ruxxzif89/rb87-eit-lab-guide/diy-stl/sas-cell-assembly-reference.stl

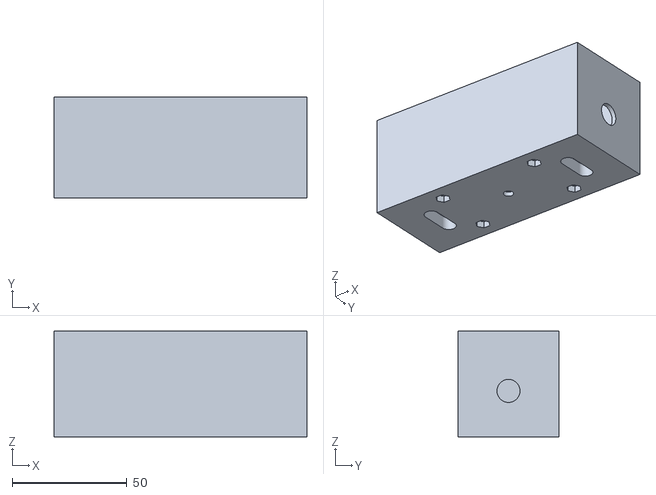
[picture p1: CAD file, 2026-10-17]
diy-stl/sas-cell-assembly-reference.stl
110.0 x 44.0 x 46.0
