ruxxzif89/rb87-eit-lab-guide/diy-stl/pbs-holder-assembly-reference.stl

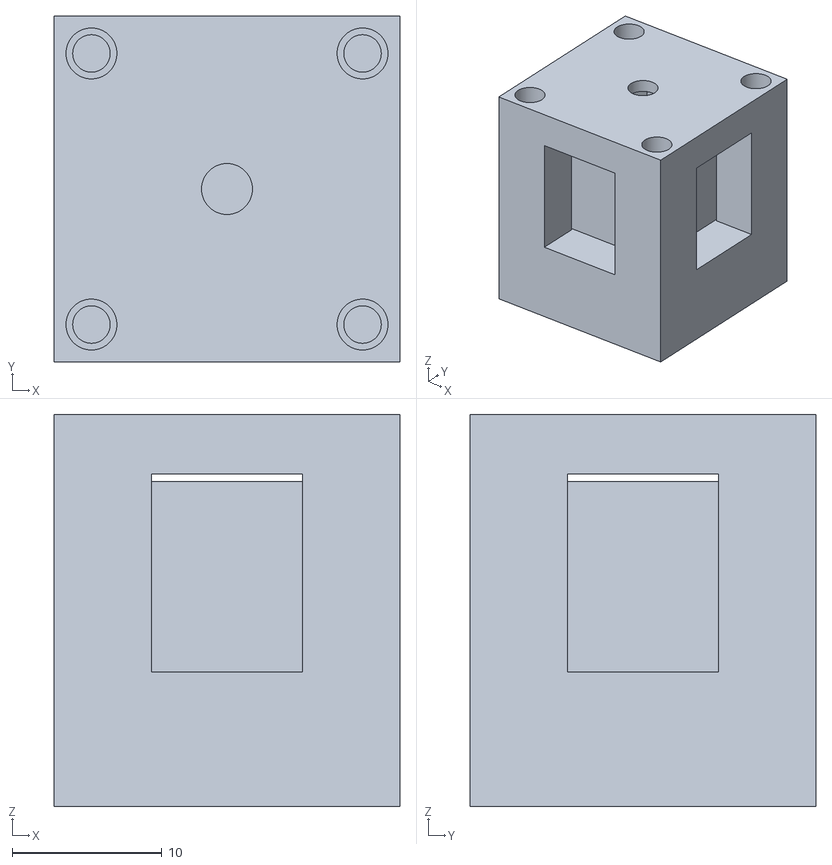
[picture p2: CAD file, 2026-10-14]
diy-stl/pbs-holder-assembly-reference.stl
23.1 x 23.1 x 26.2
