ruxxzif89/rb87-eit-lab-guide/diy-stl/d1-former-petg-seat065.stl

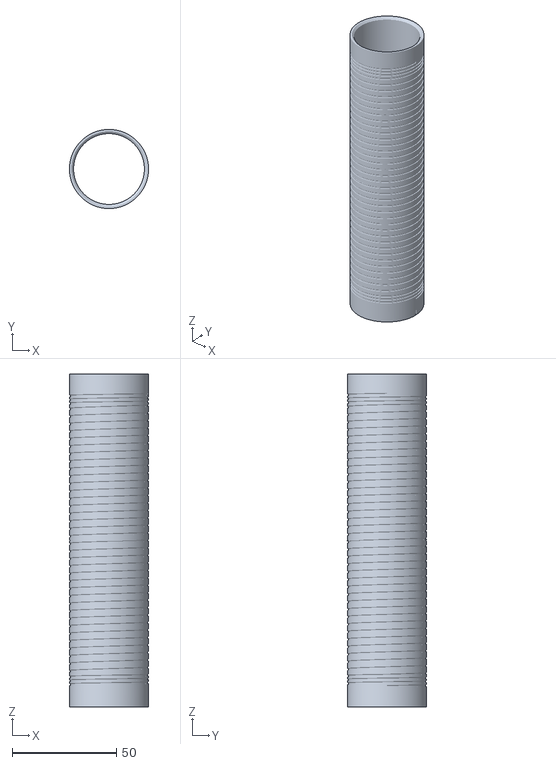
[picture p3: CAD file, 2026-10-17]
diy-stl/d1-former-petg-seat065.stl
38.0 x 38.0 x 160.0
