ruxxzif89/rb87-eit-lab-guide/diy-stl/d1-former-test-coupon.stl

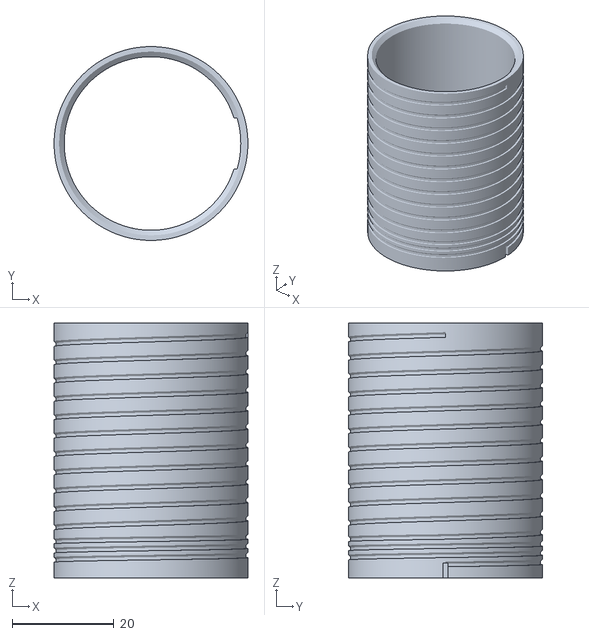
[picture p5: CAD file, 2026-10-17]
diy-stl/d1-former-test-coupon.stl
38.0 x 38.0 x 50.0
