ruxxzif89/rb87-eit-lab-guide/diy-stl/sas-cell-cover.stl

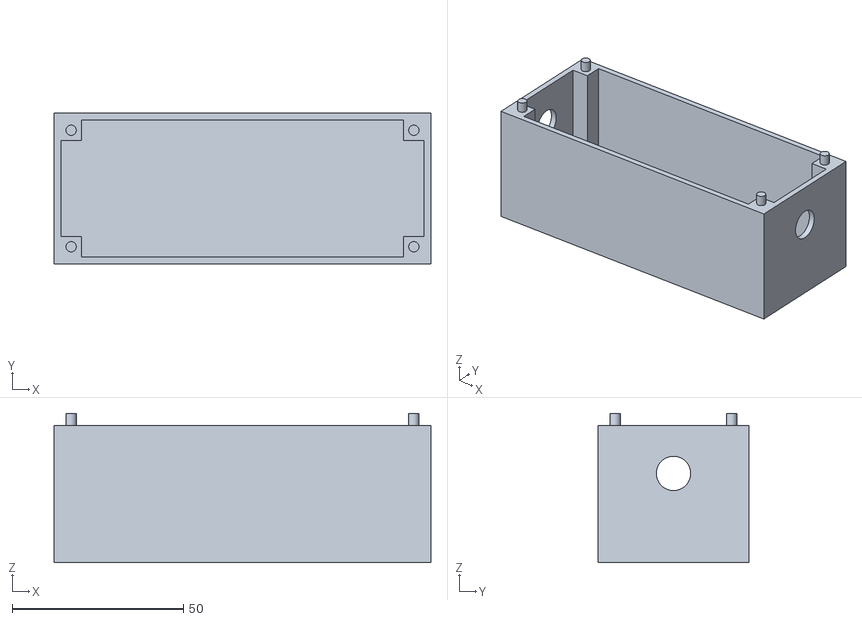
[picture p6: CAD file, 2026-10-17]
diy-stl/sas-cell-cover.stl
110.0 x 44.0 x 43.5
