ruxxzif89/rb87-eit-lab-guide/diy-stl/pbs-holder-insert.stl

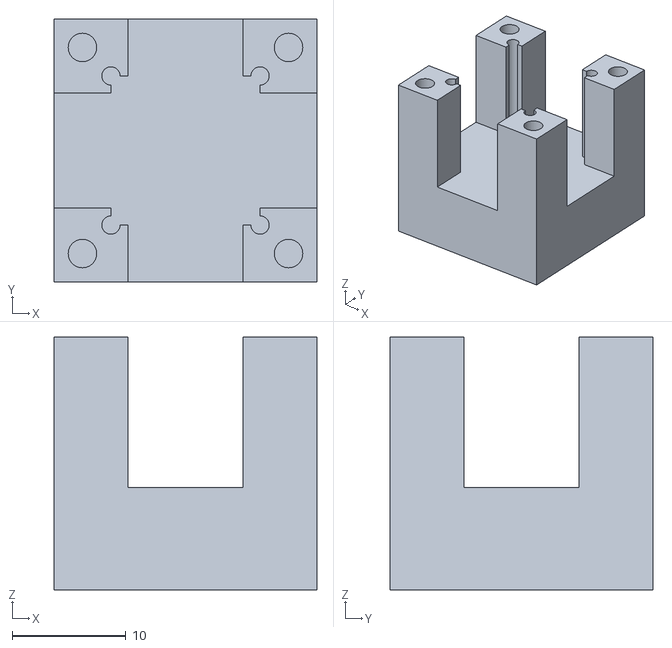
[picture p7: CAD file, 2026-10-14]
diy-stl/pbs-holder-insert.stl
23.1 x 23.1 x 22.2
