ruxxzif89/rb87-eit-lab-guide/diy-stl/pbs-holder-clamp.stl

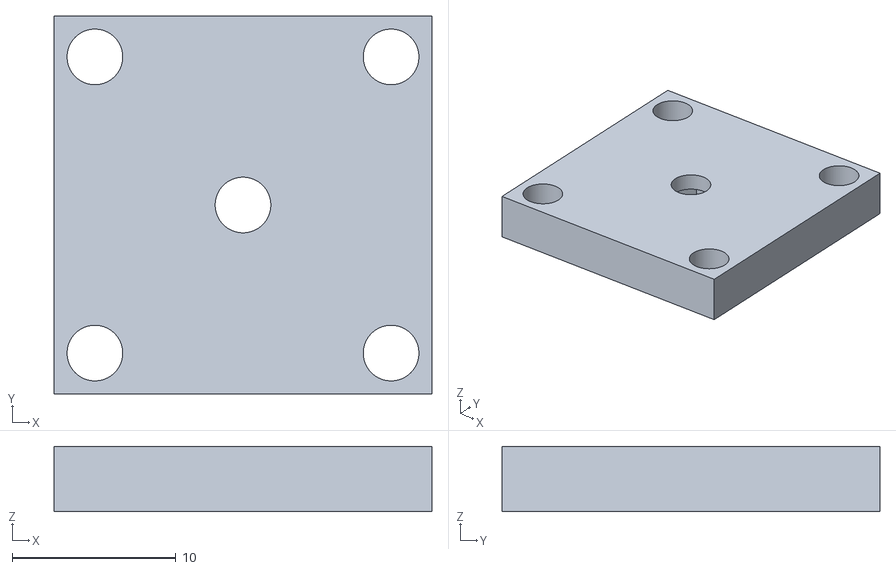
[picture p8: CAD file, 2026-10-14]
diy-stl/pbs-holder-clamp.stl
23.1 x 23.1 x 4.00
