ruxxzif89/rb87-eit-lab-guide/diy-stl/pbs-holder-insert-coupon.stl

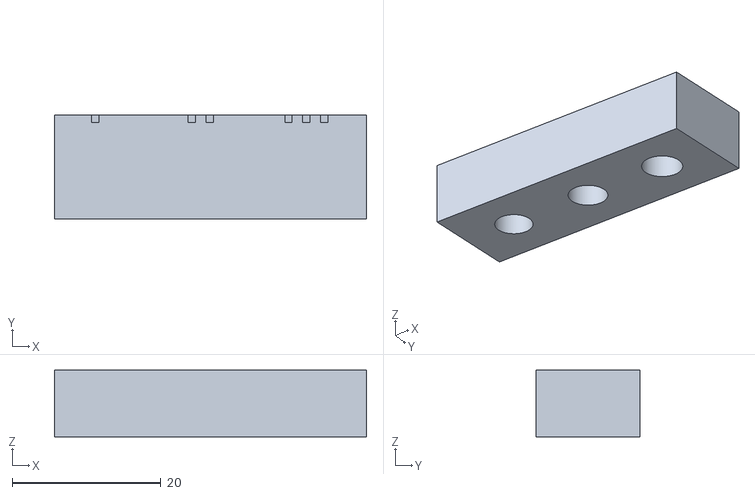
[picture p9: CAD file, 2026-10-14]
diy-stl/pbs-holder-insert-coupon.stl
42.0 x 14.0 x 9.00
