ruxxzif89/rb87-eit-lab-guide/diy-stl/d1-spacer-ring-far-end.stl

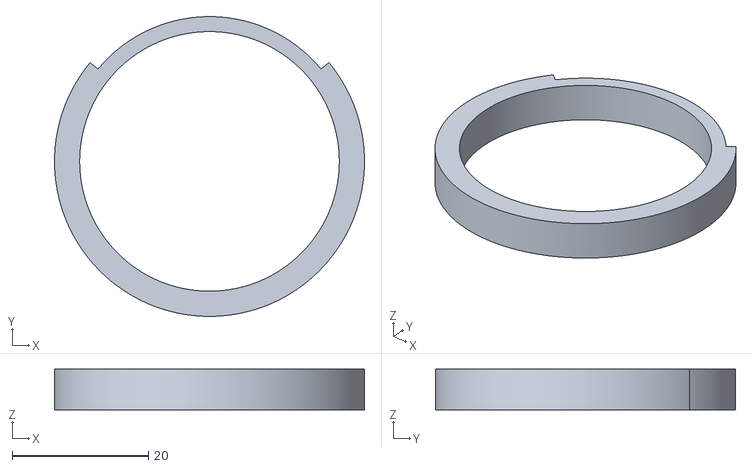
[picture p11: CAD file, 2026-10-11]
diy-stl/d1-spacer-ring-far-end.stl
45.5 x 44.0 x 6.00
