ruxxzif89/rb87-eit-lab-guide/diy-stl/d1-shield-cradle.stl

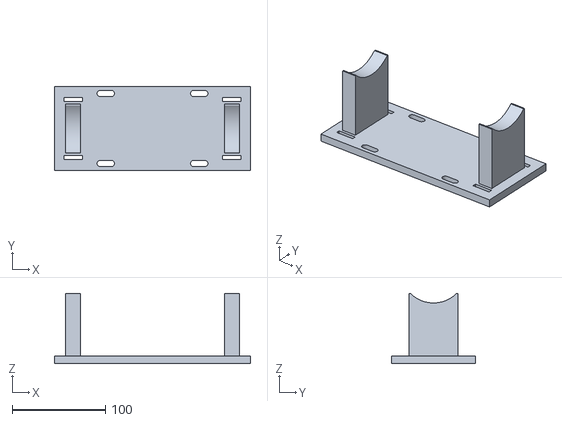
[picture p12: CAD file, 2026-10-11]
diy-stl/d1-shield-cradle.stl
210.0 x 90.0 x 75.3
