ruxxzif89/rb87-eit-lab-guide/diy-stl/sas-cell-strap.stl

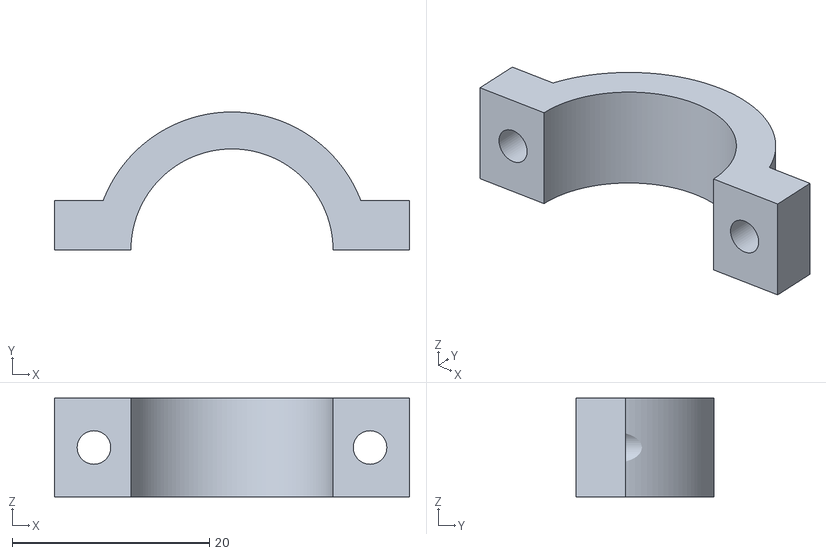
[picture p13: CAD file, 2026-10-11]
diy-stl/sas-cell-strap.stl
36.0 x 14.0 x 10.0
