ruxxzif89/rb87-eit-lab-guide/diy-stl/sas-cell-cradle.stl

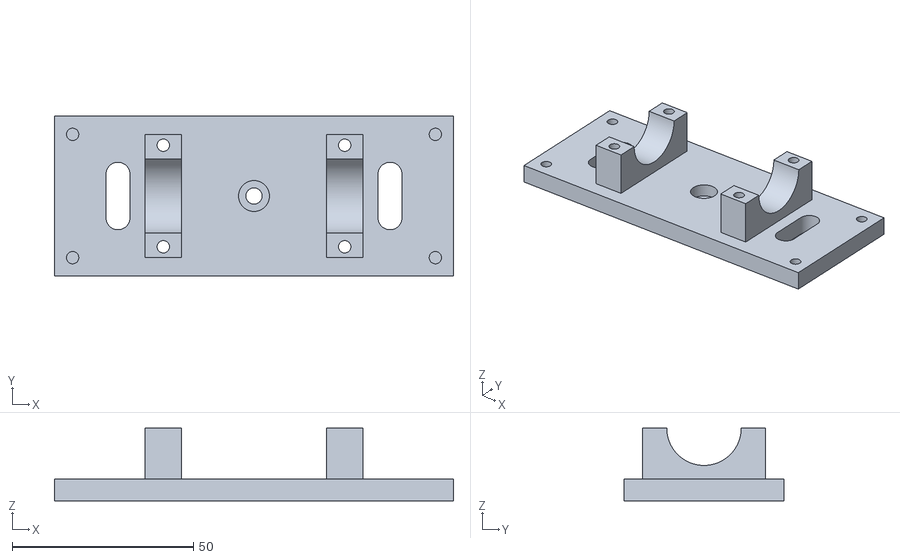
[picture p14: CAD file, 2026-10-11]
diy-stl/sas-cell-cradle.stl
110.0 x 44.0 x 20.0
