ruxxzif89/rb87-eit-lab-guide/diy-stl/d1-winding-reference.stl

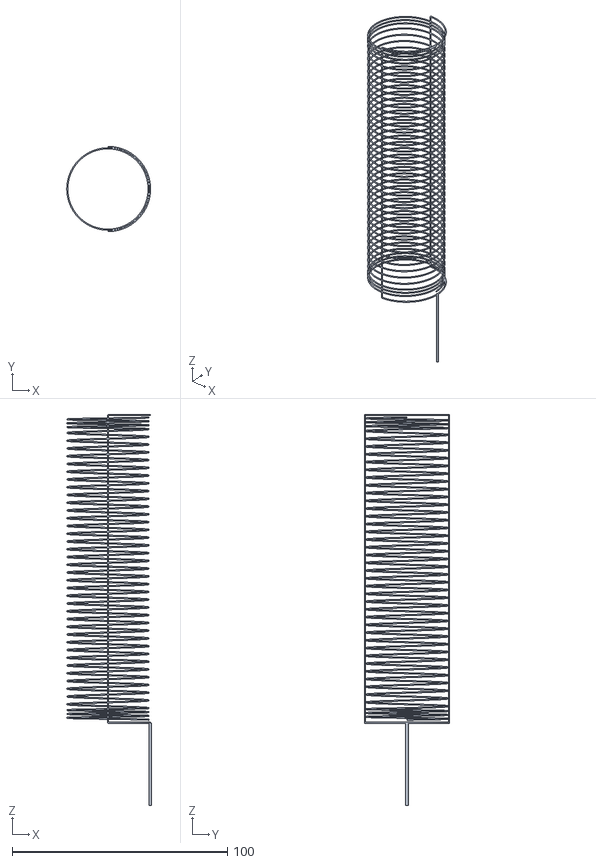
[picture p15: CAD file, 2026-10-11]
diy-stl/d1-winding-reference.stl
39.3 x 39.7 x 181.6
