ruxxzif89/rb87-eit-lab-guide/(list of files, cad)

Other CAD files:
diy-stl/d1-former-petg.stl
diy-stl/d1-former-test-coupon-seat065.stl
diy-stl/pbs-holder-screw.stl
