ruxxzif89/rb87-eit-lab-guide/(commit log)

2026-10-06 Method A only; rebuild 3D bench renderer
    Remove Method B (page, links, simulator mode, physics). New 3D renderer: detailed component models, shadows, live beam cross-fade, beam glow/stray-light markers, beam info labels, camera views, filters, shield cutaway, 12-step guided tour, richer component notes.
2026-10-06 Fuller reference bench: folded beam paths, 10 mirrors, irises, dumps, expander
    Reference layout grows from 22 to 42 parts: master-axis mirrors and irises, folded SAS arm, folded control and probe arms with double-pass separators, control beam expander, recombiner, and six beam dumps. Tour and component notes updated; camera presets refit.
2026-10-06 Complete reference bench: separate double-pass assemblies, full SAS arm, RF chain, bigger table
    AOM tracer now handles the returning pass so a double pass can be built from PBS, AOM, lambda/4, lens, retro mirror and dumps. New parts: Rb reference cell, RF source/attenuator/amplifier, coil current source, temperature controller, oscilloscope. Reference bench grows to 71 parts on a 1200x750 mm table; routed cables, 26-step tour, updated notes.
2026-10-06 Reset button, full wiring and diagram, detailed equipment list, gated costed BOM hook
    Reset bench & view button; power meter and PSU; scope/lock-monitor/sync cables, cable colour legend; wiring diagram and cable schedule; 67-line equipment list with qty, spec, reason and link (quantities checked against the 3D bench); password-gated costed BOM block (endpoint empty until the private Apps Script is deployed). Prices and the Apps Script live in the git-ignored private/ folder.
2026-10-06 Connect costed BOM endpoint
2026-10-06 Costed BOM: owned/borrowed ticks, live totals, browser + database saving, named versions
    Apps Script gains list/load/save/rename/delete backed by a Google Sheet; page keeps ticks in localStorage and syncs a working copy; versions can be saved, updated, renamed, loaded and deleted. Tested with a mock API and Node stubs of the Apps Script.
2026-10-06 Costed BOM: Remove tick, optional items removed by default, synced with database
    Rows have exclusive Have it / Remove ticks; optional items default to removed; totals show purchase, kept optional, owned/borrowed and removed; states stored as have/remove/keep (legacy true loads as have). Apps Script updated and tested in Node; UI tested against a mock API.
2026-10-06 Equipment tab with three.js pictures of every item, cheaper-alternative tick in the costed BOM, rename Method A to Zeeman EIT
    - parts3d.js: shared three.js model library (simulator parts + cables, tools, safety gear), lazy thumbnails, click-to-rotate viewer
    - equipment.html: new tab with the equipment table and the password-gated costed BOM (moved from index.html)
    - costed BOM: new 'cheaper alternative found' tick reveals an estimated price and product link; totals use it and show the saving
    - 'Method A' renamed 'Zeeman EIT' everywhere (Method B no longer exists); nav and docs updated
2026-10-06 Replace free-space isolator with a fibre dual-stage PM isolator; correct the laser to the PM-fibre-pigtailed BFY12
    - BOM: L01 laser is now EYP-DFB-0795-00015-1500-BFY12-0005 (PM fibre, FC/APC, built-in micro-isolator); the previously listed BFW11 is a free-space collimated output
    - BOM: L06 is a fibre-based dual-stage PM isolator (catalogue 40 dB min, 50-55 dB typical); the collimator now follows it
    - Simulator: laser has a fibre pigtail, isolator is drawn as fibre isolator + collimator, 80 % transmission / 40 dB; texts, tour, diagram and lecture table updated
    - parts3d.js: new fibre isolator model
2026-10-06 3D Bench tab, roomier reference layout and named zones on the optical table
    - bench.html: full-page 3D bench simulator (side panels can be hidden), new nav tab
    - Simulator code moved to shared eitphys.js and bench-sim.js (used by index.html and bench.html)
    - Reference bench spread out 1.5x on a 1.8 m x 1.2 m table (cat's-eye lenses now one focal length from their mirrors); still 9/10 objectives, locked, no warnings
    - Painted zones with name chips: source, SAS, control arm, probe arm, cell and detection, RF chain, field/heater/scope; Zones toggle
    - Camera views refit to the new table and to the view's aspect ratio
2026-10-06 Spread the reference bench 2x on a 2.4 m x 1.6 m illustrative table
    Double-pass arms keep their physical size (lens still about one focal length from its mirror); camera views, lights and shadows refitted. Still 9/10 objectives, locked, no warnings.
2026-10-07 Main vapour cell is now the Ø19 x 75 mm Precision Glassblowing quartz cell
    BOM C01 (AB-RB-Q-UV-19X75-AW), heater C02/C03, solenoid C07 and cell holder M04 updated; simulator and equipment pictures redrawn at Ø19 mm.
2026-10-07 Lab Inventory tab: editable list of what the lab owns with 3D pictures, specs and BOM links
    - inventory.html, inventory.js, inventory-data.js (default list from the lab's component sheet, DSO7104B, 86142B OSA)
    - Edits kept in the browser; optional shared list through the password-protected Apps Script (new invget/invset actions)
    - parts3d.js: new models (base plates, rod clamp, rotation stage, goniometer, XYZ stage, FiberBench, post holder, tube adapter, OSA, generic)
    - Nav on every page now has 5 tabs; narrower phone padding
2026-10-08 Notes for resuming on several machines; BOM build no longer depends on /tmp
2026-10-08 BOM M03: posts are Ø1/2 inch
2026-10-08 Cells: Ø25 × 25 mm isotopically pure Rb-87 + 10 Torr Ne EIT cell and Ø25 × 75 mm buffer-gas-free SAS reference cell
2026-10-08 Cells: supplier's standard quartz O19 x 75 mm body for both cells (natural-Rb stock cell for the lock, enriched Rb-87 + 10 Torr Ne for EIT, uncoated windows)
    Supersedes the O25 x 25 mm cell of 3a5556d: simulator cell and reference cell, equipment pictures, info texts and the BOM tables are back to O19 x 75 mm, following the supplier's standard product and the user's decision.
2026-10-08 EIT cell follows the published experiment: quartz, O25 mm, 25 mm vapour path, enriched Rb-87 + 10 Torr Ne, uncoated; lock cell stays the stock O19 x 75 mm natural-Rb cell
    Simulator, equipment pictures, info texts and BOM tables updated; the standard-body decision of 40b9fde applies to the lock cell only.
2026-10-08 Laser controller: Thorlabs ITC502 (in the lab) replaces ITC4001; added to the Lab Inventory
2026-10-09 Add a Quantum Spain-style bench tab: two 450 x 450 mm breadboards (SAS lock and EIT with two AOMs), instrument shelf, identified equipment and probable BOM
2026-10-09 Spain-style bench: 'Equipment & cost' jump button, strip under the 3D view, scroll position and open cost box kept across a refresh
2026-10-09 Spain-style bench: valid x3.3 control expander (f 30 + f 100, 130 mm apart), 75 mm cat's-eye lens labels, note on the hidden 160 MHz lock offset
2026-10-09 Lab Inventory: second ITC502, ILX LDM-4980 mounts and cable sets, TCLDM9 mounts, Credix SG-1710 generator, Newport AD-300/DC detector
2026-10-09 Lab Inventory: OMH-6745B (950-1650 nm) is not suitable at 795 nm; OMM-6810B needs a silicon head
2026-10-10 Draw the Thorlabs PDA36A2 from its drawing (3D bench, Spain-style bench, equipment); sphere sensor model for S140C/S144C
2026-10-10 PM100USB + S140C 3D model (inventory I12, power meter on the benches); Q&A on the SolidWorks file
2026-10-10 PM100USB model follows the Thorlabs 3D drawing (aluminium extrusion, black end caps)
2026-10-10 Lab Inventory: Thorlabs S120VC (use, probe power); photodiode head model; Q&A
2026-10-10 Lab Inventory: seven items from the shelf photographs (mG mounts, PR01/M, XY stage, lens positioner, zoom lens, brass rotators, target) with 3D drawings; Q&A
2026-10-10 Main switch 'Count what the lab already owns': green rows and reduced totals in the costed BOM and the Spain-style cost box; Q&A
2026-10-10 Q&A: FLC100 fluxgate magnetometer
2026-10-10 Fluxgate row: note the lower-cost FLC100 listing; costed BOM pre-ticks a server-side alternative (no price in public files)
2026-10-10 Q&A: FLC100 wiring note
2026-10-10 Inventory: ITC502 assignment; Q&A: second ITC502 as the cell heater controller
2026-10-10 Q&A: solenoid supply options; correct the field-stability figure
2026-10-10 ITC502: pinout and wiring from the operation manual (heater on the TEC output, solenoid on the laser output); Q&A
2026-10-10 Wiring schematics of the second ITC502 (heater and solenoid) in section 09; Q&A image support
2026-10-10 ITC502 wiring drawn on the real rear panel and connector layout (rear, heater, solenoid figures); every Q&A answer shows its 3D equipment pictures
2026-10-10 DIY Section tab, Reading Section rename, merged Q&A, BOM part-number fixes
    - New tab "DIY Section" (diy.html, 23 drawings diy-*.svg): ten parts built in the lab,
    D1 solenoid former and winding, D2 cell stack and bifilar heater, D3 ITC502 plugs and
    cables, D4 degaussing coil and drive, D5 backup current source, D6 lock-box divider,
    D7 fluxgate supply and holder, D8 RF chain and bias box, D9 AOM yaw platform and Bragg
    set-up, D10 beam dumps and covers. Each part: parts list (no prices), tools, dimensioned
    drawings and wiring schematics, numbered steps with a check, tests, mistakes, open items.
    - Top bar on every page: Reading Section first (quantum.html renamed from Quantum Optics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
2026-10-10 Q&A: AeroDIODE 795 nm DFB against the Eagleyard BFY12; DIY D6/D10 text for the 30 mW laser; hand-over notes
    - Section 09 / QA.md: new entry comparing the AeroDIODE 795LD-1-SM/PM-NI with the Eagleyard BFY12 (table, questions for the vendor, design changes, verdict), 3D pictures, no prices. 18 entries.
    - DIY Section: D6 note (divider 33 kohm for the AeroDIODE, 0.474 GHz/mA), D10 dump text (up to about 30 mW); figure diy-d10-dump.svg updated.
    - CLAUDE.md: "Where we left off" section (state, open design questions, how to continue on another machine, pre-push rules).
2026-10-10 Q&A: remove a loose price hint from the backup-current-source answer; pre-push rule also checks the word ringgit
2026-10-10 Q&A: is an isolator mandatory when most of the bench is free space? New answer with a feedback budget (19 entries)
    - New entry in section 09 / QA.md: why a DFB laser needs an isolator (published feedback regimes, double-pass wave-plate leak, flat surfaces), isolation against feedback table, what to do (fibre isolator first, free-space alternative, do not order the optional collimator), verdict. Seven 3D pictures, no prices.
    - AeroDIODE entry: isolation bullet now points to the new answer and no longer mentions the budget.
    - CLAUDE.md: entry counts.
2026-10-10 Laser decision: keep the Eagleyard (Toptica) laser with the dual-stage fibre isolator; remove the alternative laser from the guide
    - Q&A (section 09, QA.md): the comparison entry is removed (18 entries); the isolator answer is rewritten around our own laser (micro-isolator inside plus fibre isolator L06, feedback table, check the replacement of the BFY12), now question 2.
    - DIY Section: the D6 note for the other laser (divider 33 kohm) is removed; the D10 dump text is back to the 15 mW laser (diy-d10-dump.svg updated).
    - CLAUDE.md: laser question marked as decided; entry and audit counts.
2026-10-11 Q&A: can the cell be heated the Duke way (foil-wrapped heater)? (19 entries)
2026-10-11 DIY D1: step-by-step 3D build simulator (diy-d1-sim.html); spacer rings get a notch for the leads and a flat for the degaussing bundle
2026-10-11 DIY D1: printable PETG former for the Bambu Lab A1 (STL files, test coupon, spacer rings, winding reference) with slicer settings; Q&A on 3D printing the former
2026-10-11 DIY D1: Bambu Lab A1 0.2 mm nozzle settings field by field; 0.65 mm seat variant of the former and coupon; Q&A on groove accuracy
2026-10-11 Q&A: making the mu-metal shield (rolling, annealing, seams, printed caps)
2026-10-11 D2 heater: safety box, current limits 0.50 A on the bench and 0.33 A in the shield (runaway stays below 85 C); Q&A on the heater wrapped round the cell
2026-10-11 DIY D11: 3D-printed PETG holder for the SAS reference cell (cradle, straps, cover, STL files); BOM S02 now the printed holder; Q&A
2026-10-11 Equipment S02: SAS cell holder printed in the lab (no purchase), link to the STL files in DIY D11
2026-10-11 Q&A: common beam height (about 100 mm) for our larger shield; end-cap cable holes
2026-10-11 Q&A: the 100 mm beam height adds no cost
2026-10-11 Q&A: enclosure for the EIT cell at the 100 mm beam height
2026-10-11 Bench synced to a 100 mm beam height; shield end caps with a beam hole and separate cable holes; printed shield cradle (BOM M06)
    - 100 mm everywhere: equipment list M03, DIY D9 (AOM), D10 covers 160 mm inside (drawing redrawn), D11 post 80 mm, 3D bench (Spain-style page keeps its own low height), D1 build simulator.
    - End caps: 14 mm beam hole on the axis and a 12 mm cable hole 16 mm off it in all caps; D1, D4, D7, open items, fit and D4 drawings, C05 text and the simulator updated; spacer-ring recess moved to 90 degrees from the lead notch.
    - New d1-shield-cradle.stl and BOM row M06 (printed in the lab); audit 48 checks; Q&A updated.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
2026-10-14 Isolator: free-space Thorlabs I795P3D after the collimator replaces the dual-stage fibre isolator (BOM L06, guide text, simulator, 3D model, Q&A)
2026-10-14 Q&A: is the Yanban RB-795-DFB-BFW laser (Alibaba listing) suitable; remove a vendor price from the SAS cell row
2026-10-14 Q&A: the Yanban RB-795-DFB-BFW on our ITC502 (ranges, wiring, lock divider); thermistor 200 kOhm range noted
2026-10-14 Q&A: AOM and RF driver specification for quotes (third AOM in the SAS arm for the lock offset)
2026-10-14 PBS specification Q&A; discontinued CM1-PBS252 and CM1-BS014 replaced by CCM1-PBS252/M and CCM1-BS014/M (BOM O03, O04)
2026-10-14 Q&A: cheaper unmounted PBS cubes (what to search and ask for) and how to mount them
2026-10-14 Q&A: is a 3D-printed PBS holder precise enough (judgement, conditions, acceptance test)
2026-10-14 Q&A: PBS holder wording (heat)
2026-10-14 Q&A: resin printer as the alternative for the PBS cube holder
2026-10-14 DIY D12: 3D-printed PETG holder for unmounted 1/2-inch PBS cubes (M4 heat-set insert or screw version, clamp, insert coupon, drawing, steps); linked from BOM O03 and the PBS Q&A; lock-offset open ite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
2026-10-14 Q&A: Yanban laser, free space or PM fibre, and the acceptance test on arrival
2026-10-14 Site-wide laser switch (Eagleyard BFY12 / Yanban RB-795-DFB-BFW): equipment rows L01, L03, L05, L06, guide source card and first build steps, simulator texts, DIY D6 divider (120 kOhm for the Yanban,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
2026-10-14 AOM: G&H 3080-125 drawing checked (SMB input, 442-633 nm coating on rev D, polarization, housing); Q&A, BOM O17 and DIY open items updated; no separate driver needed
2026-10-14 RF chain audit: ZHL-1-2W-S+ gain corrected to the data sheet (29 min / 32 typ), synthesizer at +1 dBm keeps +30 dBm at the AOM; Q&A table of R01-R06 against the AOMs and the open checks
2026-10-14 Equipment list: the "in the lab" status links to the Lab Inventory, which highlights and scrolls to the items that cover that row (?bom=)
2026-10-15 Q&A: vendor-neutral specification for the 795 nm DFB laser
2026-10-15 Q&A: PBS supplier sheets, check the design wavelength (1064 nm cubes are not for 795 nm)
2026-10-15 Q&A: free-space DFB in published work (the reference guide's own route: free-space laser, isolator, optional PM-fibre coupling)
2026-10-16 Q&A: AOM and RF driver decision path; can the home-wound solenoid give 3.39 mG/mA and how to measure it (fluxgate free space, in the shield, then the atoms)
2026-10-16 Interactive 0.7 vs 1.4 kHz per mG flow page (solenoid current -> sub-levels -> light and RF difference -> EIT peak) and a flow drawing in the Q&A
2026-10-16 Distance calculator (collimator, Gaussian beam path with apertures, double-pass cat's eye, arm-length difference, iris accuracy) and Q&A entry; corrected phase variance wording
2026-10-17 Real cells have a torch-sealed stem: EIT cell stem limited to 4 mm by the solenoid bore (C01 spec, D2 heater gap, foam hole, stem NTC, coupon test-fit), fallback table for taller stems, SAS cover clo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
2026-10-17 Printed former and test coupon: stem channel along the top of the bore (10 x 0.6 mm, cable end to 86 mm) and entry chamfers; cell-stack reference STL with automatic fit check; D2 drawing, figure and 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
2026-10-19 DIY audit: heater runs kept on the barrel and wire length with turnarounds (12.5 ohm), thin heater and NTC cables; D8 lock offset decided; D9 -160 MHz, 100 mm check, SMB cable, real G&H housing, pola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
2026-10-19 D1 simulator: foam sleeve 3.0 mm with the stem hole, wrapped on; D2 drawing says 3.0 mm
2026-10-19 Q&A: why the fluxgate is calibrated in the cell position first and then swapped for the cell
2026-10-19 Q&A: making the free-space Yanban beam equal to a PM-pigtailed laser (fibre coupling sequence, alignment, metal mount)
2026-10-19 Yanban option: free-space laser with two isolator stages; PM-fibre link as an optional row; Q&A: the fibre is optional and what it adds
2026-10-19 3D laser-source simulation: free-space Yanban direct or through a PM fibre, data-sheet values, budgets and alignment steps; Q&A link and beam-size row
2026-10-19 BOM: optional Yanban-only row L07, two steering mirrors (OQAg-25.4 or PF10-03-P01) in KM100 mounts for the PM-fibre link; 3D laser-source spec table
2026-10-19 Yanban setup through the PM fibre: L05 fibre link and L07 mirrors to procure, Q&A updated, 3D laser source opens on the fibre layout
2026-10-19 Yanban option: O01/O02 rows state 11 on the bench + 2 in L07 = 13 mirrors and mounts
2026-10-19 BOM: mirrors O01 and mounts O02 now 13 (11 bench + 2 for the free-space Yanban fibre coupling); separate L07 row removed
2026-10-19 AOM supplier reply: AOM only (795 nm, 80 MHz, 2 mm, SMA, 2 W, >85 %), driven by our RF chain; synthesizer never above +2 dBm; SMA cable in D9; Q&A update
2026-10-20 Q&A: route A is boxed modules and cables, not a home-made driver; how to simplify it
2026-10-20 Yanban is the default laser option (Eagleyard stays selectable); laser-box texts updated
2026-10-20 Site icon: atom with a laser beam (favicon.svg, apple-touch-icon.png) on every page
2026-10-20 Q&A: OQAg-25.4 suitability for every mirror role; fibre launch: half-wave plate after the steering mirrors (silver mirrors at 45° need s or p polarization), 3D page and sequence updated
2026-10-20 Site-wide keyword search: Search button in the top bar (Ctrl+K or /), index of 417 sections (pages, Q&A entries, equipment rows, inventory items), results open the section with the words highlighted
2026-10-20 Yanban is the only laser: Eagleyard rows, laser switch and single isolator removed; 3D bench has the free-space laser, two isolators and a half-wave plate; Q&A on route A simplification and 0.25 mm2 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
2026-10-20 3D bench: PM-fibre link drawn (two FiberPort ends, fibre coil, light through the fibre both ways); audit by ablation removes the idle control-arm half-wave plate; mirrors 11 and mounts 11 (master-axi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
2026-10-20 BOM: "in the lab" rows name the Lab Inventory items they refer to; build_bom checks BOM and inventory stay in sync (lab row without inventory item, or inventory item pointing at a removed row, stops 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
2026-10-20 Costed BOM: the "in the lab" badge is now a link to the Lab Inventory and names the inventory items behind it (shared list from lab-cover.js)
2026-10-21 Q&A: audit of the FAOM-780-80-1-L-T-A-K 1 mm free-space AOM (data sheet checks, beam must be about 0.6 mm, RF power and polarization unknown, questions for the vendor, what survives an EIT adjustment)
2026-10-21 AOM: FAOM-780-80-1-L-T-A-K chosen (vendor reply read: 1 W CW limit, polarization and axis height still open); BOM O17, DIY D8/D9 (1 W rule, 0.9 mm beam, vendor outline), audit 84 checks, Q&A updated
2026-10-21 Q&A: second data sheet (FAOM 2 mm, 2 W) compared with the 1 mm version; correction of the vendor price reading (same price for both models)
2026-10-21 AOM: switch to the 2 mm FAOM-780-80-2-L-T-A-K (2 W, 3 x 2 mm): BOM O17, DIY D8/D9 texts and drawings, audit, Q&A decision
2026-10-22 Q&A: CSRayzer answers on the FAOM-780-80-2 (random polarization, 2 W for the 85 %, 4 W maximum, no heat sink, coating, beam size, no pre-shipment test)
2026-10-22 AOM: vendor drawing of 22 Oct (axis 8.2 mm, Ø4 and M2 holes) applied to D9, BOM O17 text and drawing
2026-10-22 Lab Inventory: 4 confirmed Melles Griot mirror mounts (aperture about 1 inch), more to count; inventory-data v18
2026-10-23 Q&A: tuning the laser to 794.98 nm with temperature and current; Yanban and BrandNew data sheets compared
2026-10-23 BOM: lock-box accessory rows L07, L08; Q&A and D9: CSRayzer second reply (test at 1 W and 2 W, order route)
2026-10-23 Laser-lock wiring: 3D guide (PDA36A2 -> Red Pitaya/Linien -> D6 -> ITC502 MOD IN), block diagram; Q&A on the Red Pitaya and Linien; divider values corrected to 120 k + 1 k; BOM lock-box rows
2026-10-23 DIY Section: part D13 (lock box: Red Pitaya, Linien, wiring) with steps, tests and drawing; audit 89 checks
2026-10-28 BOM R01: Rigol DG4102 two-channel source (SynthHD kept as alternative); search index
2026-10-28 Q&A: Rigol DG4102 as the AOM drive, what the FM scan is, minimal RF chain
